FireMask/OpenPlayer/docs/pcb-requirements.md

# OpenPlayer PCB Rev C — Project Requirements

**Document type:** Hardware requirements and design brief  
**Status:** Rev A designed in SPEC 22 (`specs/22-carrier-pcb.md`), reworked into the thin, single-sided Rev B in SPEC 24 (`specs/24-carrier-pcb-rev-b.md`), then into the Rev C Pi sandwich in SPEC 25 (`specs/25-carrier-pcb-rev-c.md`); sources in `hardware/pcb/`  
**Target CAD:** KiCad 10  
**Target manufacturer:** JLCPCB  
**Main controller:** Raspberry Pi Zero 2 W  
**Display:** 1.28-inch round TFT, GC9A01, 240 × 240, SPI  
**Battery concept:** Single-cell LiPo, nominal 3.7 V, 4000 mAh, 6 × 60 × 91.5 mm  
**Charging module:** FM5324GA USB-C charge/boost board (DWEII, Amazon MX B09YD5C9QC), 5 V / 2 A output  
**Revision:** C (Rev A and Rev B only in git history)

---

## 1. Project goal

Design a custom printed circuit board (PCB) for a portable, modular DIY MP3 player named **OpenPlayer**. The current prototype works at a basic level on a Raspberry Pi Zero 2 W. The PCB is a **bridge board**: it contains no active circuitry, only reliable, labeled, serviceable connectors for:

- Raspberry Pi Zero 2 W, plugged into a 2 × 20 socket on the back of the board (HAT style, 11 mm standoffs).
- A 1.28-inch round GC9A01 240 × 240 SPI TFT display ("1.28 TFT ver 1.0", 7-pin header, no backlight pin), soldered on the front of the board by its own header.
- Six physical control buttons on a separate button board.
- A power-on key on the case's top edge.
- The 5 V output and `K` (key) pad of the charging module, connected by short wires.
- A panel-mount power switch, connected by short wires.

The battery connects straight to the charging module and never touches this PCB.

**Case target:** portrait, Walkman size, ≈ 80 W × 110 H × 33 D mm (inside ≈ 74 × 104 × 29), held in the right hand. Front to back: display, carrier, Pi, insulating sheet, battery (~28.3 mm in all). The carrier and Pi take the top ≈ 53 mm; the bottom zone holds the charging module, USB OTG adapter and DAC, with the headphone jack and charging USB-C in the bottom wall. Button strip on the right wall, POWER key on the top edge.

## 2. Existing software and system architecture

The PCB is hardware interconnect and power distribution; it is not intended to replace the Raspberry Pi or run application software itself.

The Raspberry Pi Zero 2 W will continue running Raspberry Pi OS and the existing MP3-player software architecture:

- MPD as the playback engine and source of playback state.
- A central C#/.NET service for player logic.
- A Python GPIO hardware agent for physical button input and display rendering (pins configurable in `player.json`; defaults below).
- SSH for administration.
- SPI display control for the GC9A01.
- Existing USB DAC for audio output.
- Bluetooth headphone output is a desired capability of the software/system, not a PCB audio codec requirement.

Do not move the project to an ESP32 as part of this PCB revision.

## 3. Design principles

1. **Modular:** the Pi, battery, charging module, display, and button board are replaceable without reworking the PCB.
2. **Safe power design:** no direct connection from a Li-ion cell to the Pi's 5 V supply input. Only the module's regulated 5 V reaches the PCB.
3. **Power-path:** handled by the charging module; the PCB adds none.
4. **Stable 5 V rail:** both Pi 5 V pins and all GND pins carry power through J1; optional bulk capacitor C1.
5. **Serviceable:** keyed/polarized connectors, clear silkscreen labels, mounting holes, and test points.
6. **KiCad source-first:** schematic and PCB are generated by scripts in `hardware/pcb/scripts/` and kept under version control.
7. **Fabrication-ready:** Gerbers and drill files for JLCPCB only after ERC/DRC and physical review.
8. **Do not assume module pinouts:** verify each purchased module's exact pin labels, connector pitch, voltage limits, and datasheet before ordering.

## 4. Functional blocks

### 4.1 Raspberry Pi connection — J1

- J1: 2 × 20, 2.54 mm female socket, vertical, 8.5 mm tall, on the **back**. The Pi plugs in component side toward the carrier, like a HAT. J1 pin N = Pi physical pin N.
- The Pi's outline is flush with the carrier's bottom edge, so its ports (mini-HDMI, USB OTG, PWR) face the bottom of the case. Four M2.5 holes on the Pi's 58 × 23 pattern carry 11 mm standoffs (socket 8.5 + Pi header plastic 2.5).
- `build_pcb.py` checks every J1 pad against the official Pi Zero 2 W drawing (pin 1 at the left end, inner row, seen from the front). A mirrored J1 would put 5 V on GPIO.
- No copper pour over the Pi's Wi-Fi/BT antenna (between its mini-HDMI and USB OTG ports).
- The Pi is powered through header pins 2 and 4 (5 V) with all 8 GND pins (6, 9, 14, 20, 25, 30, 34, 39).
- **Never plug power into the Pi's micro-USB PWR port while it is on the carrier** (dual feed). The silkscreen carries this warning; block the port in the enclosure.
- Measure 5 V at the Pi under load at bring-up; it must stay ≥ 4.75 V.

### 4.2 Display connector — J5

Display: GC9A01, 1.28-inch round TFT, 240 × 240, SPI. J5 is a row of 7 plated holes (2.54 mm) for the module's own pre-soldered 1 × 7 header: the module sits on the **front**, its header goes through the board and is soldered on the back (pins trimmed to ≤ 2 mm). No cable. **Pin 1 (VCC, square pad) is the rightmost pin seen from the front.** Swapping the display means desoldering it.

Measured module ("1.28" TFT VER1.0"): 36 W × 45 H × 4 mm (round Ø36 + 23 mm-wide bottom tab); pin row 2 mm above the module's bottom edge (= the carrier's bottom edge) and 25 mm below the screen center; two M2 tab holes 19.2 mm apart, 3.5 mm above the pin row, carried on 2.5 mm standoffs (H5/H6).

7-position interface, in the module's silkscreen order. Matches the validated prototype wiring (`docs/gpio-map.md` §10) and `player.json` defaults (`hardware.display.dc` = 16, `rst` = 26):

| J5 pin | Module label | Signal | Raspberry Pi BCM GPIO | Pi physical pin |
|---:|---|---|---:|---:|
| 1 | VCC | 3V3 | — | 1, 17 |
| 2 | GND | GND | — | any GND |
| 3 | SCL | SPI0 SCLK | GPIO11 | 23 |
| 4 | SDA | SPI0 MOSI | GPIO10 | 19 |
| 5 | DC | Data/command | GPIO16 | 36 |
| 6 | CS | SPI0 CE0 | GPIO8 | 24 |
| 7 | RST | Reset | GPIO26 | 37 |

Important:
- SDA/SCL on this module are SPI data/clock, not I²C.
- VCC and logic are 3.3 V only; never 5 V.
- The module has no backlight (BL) pin: the backlight is on whenever VCC is present, including after the Pi shuts down. The charging module's auto-off (load < 50 mA) or the J6 power switch cuts it. A panel VCC MOSFET switch is left for a future spec.
- DC/RST were moved from GPIO5/GPIO6 (pins 29/31) to GPIO16/GPIO26 (pins 36/37) after a short between adjacent header pins 29–31 on the prototype. Do not revert without updating `player.json` defaults.
- SPI0 is in use, so GPIO7–11 are not free for other functions.

### 4.3 Button board connector — J4

One 8-pin JST-XH connector (right edge) to a separate button board with six normally-open momentary buttons and a shared ground. Pin 8 keeps `PWR_KEY` so the existing XH-8 cable still works; the 6-key button board leaves it unconnected.

| J4 pin | Signal | Raspberry Pi BCM GPIO | Pi physical pin |
|---:|---|---:|---:|
| 1 | GND common | — | GND |
| 2 | PLAY / PAUSE | GPIO17 | 11 |
| 3 | PREVIOUS | GPIO27 | 13 |
| 4 | NEXT | GPIO22 | 15 |
| 5 | VOL_UP | GPIO23 | 16 |
| 6 | VOL_DOWN | GPIO24 | 18 |
| 7 | MENU | GPIO25 | 22 |
| 8 | PWR_KEY | — (to J3, module `K`) | — |

Pin assignment matches `player.json` defaults and `docs/gpio-map.md`.

Button behavior:
- Each normally-open button connects its signal line to GND while pressed.
- GPIO inputs use the internal pull-up in software; no external resistors.
- `PWR_KEY` is **not** a Pi GPIO. It goes only to the charging module's `K` pad (via J3), so power-on works with the Pi off.
- The POWER key is a panel momentary key on the case's top edge, on **J7 `PWR_BTN`** (JST-XH 2 side entry, top edge): pin 1 `PWR_KEY`, pin 2 `GND`.

### 4.4 Battery and charging module

- Battery: one LiPo cell, 3.7 V nominal, 4000 mAh, 6 × 60 × 91.5 mm, with built-in protection, flat against the back wall behind the Pi (1 mm gap / insulating sheet; keep it off the Pi's antenna end if possible). It connects straight to the module's `+` / `−` battery pads. The 5000 mAh 4 × 59 × 134 cell was dropped: it needs a ~145 mm case.
- Charging module: FM5324GA USB-C board. Per seller listings (unverified against a datasheet):
  - USB-C input 5 V, charge current up to 2.4 A, cut-off 4.2 V.
  - Integrated boost: 5 V regulated output, up to 2 A, ~92.5 % efficiency at 3.6 V in.
  - A short press on `K` turns the output on; the output turns off when the load stays below ~50 mA.
  - 4 battery-level LEDs. A USB-A output on the back is not used.
- Pads used: `5V +` / `−` (output) → J2; `K` → J3. Wires are short; the module sits in the bottom zone of the case.
- The Steren ARD-343 (TP4056 type) was rejected: battery-voltage output only, no power-path, 2 A trip limit.

### 4.5 Power entry and switch — J2, J6

- J2 `PWR_IN` (JST-XH 2-pin, left edge): module 5V / GND → `5V_IN`.
- J6 `SWITCH` (JST-XH 2-pin, left edge): panel-mount rocker/toggle rated ≥ 3 A, in series between `5V_IN` and `5V_SYS`.
- `5V_SYS` feeds J1 pins 2 and 4, C1 (470 µF / 10 V, Ø8 mm, mounted lying flat, optional populate) and C2 (100 nF).
- Power tracks (`5V_IN`, `5V_SYS`, `GND`) are ≥ 1.0 mm.

### 4.6 Expansion and future additions

- Keep GPIO2/GPIO3 available for potential I²C devices.
- OLED is not part of this revision; the current screen target is the GC9A01 TFT.
- Do not add an audio DAC to this PCB; the current prototype uses an existing USB DAC.

### 4.7 Button board (SPEC 23, 6 keys since SPEC 25)

A separate 14 mm-wide strip that lies flat against the right side wall of the case (Walkman-style). Files and regeneration: `hardware/buttons/README.md`.

- SW2–SW7: 6 × 6 mm THT tactile switches (`SW_PUSH_6mm`) on the front, in one row. Top to bottom: VOL+ VOL− | PREV PLAY NEXT MENU, with a larger gap between the two groups so they can be found by touch. Actuator height is picked at purchase; all heights share the footprint. SW1 (POWER) was removed: the POWER key is on the carrier's J7.
- J1 `CARRIER`: JST-XH 8 on the back at the top end, lying along the strip. Same pinout as carrier J4 (1 GND, 2 PLAY, 3 PREV, 4 NEXT, 5 VOL+, 6 VOL−, 7 MENU, 8 KEY); pin 8 is unconnected on this board. `hardware/buttons/scripts/netlist.py` checks this against the carrier's netlist.
- **Cable:** XH-8 to XH-8, **straight**: pin 1 to pin 1 … pin 8 to pin 8. Pin 1 is marked on both boards; check continuity before connecting.
- H1–H2: M2 holes, one at each end.
- Each switch shorts its signal to GND; no pull-ups, debounce parts, LEDs or ESD parts on the board (pull-ups and debounce are in the Pi/software).
- Size: `BOARD_W` 14 mm; length follows from `BTN_PITCH` (9.6 mm), `GROUP_GAP` (4 mm) and `END_MARGIN` (5.5 mm): 100.09 mm by default (fits the ≈ 104 mm inside height).
- Two layers: signals on F.Cu, GND pour on B.Cu with F.Cu stitching.

## 5. Connector list

| Ref. | Function | Pins | Footprint |
|---|---|---:|---|
| J1 | Pi, plugged in on the back | 40 | `Connector_PinSocket_2.54mm:PinSocket_2x20_P2.54mm_Vertical` (8.5 mm) |
| J2 | `PWR_IN` from module 5 V | 2 | JST-XH S2B-XH-A (side entry) |
| J3 | `KEY` to module `K` | 2 | JST-XH S2B-XH-A (side entry) |
| J4 | `BUTTONS` | 8 | JST-XH S8B-XH-A (side entry) |
| J5 | `DISPLAY`, holes for the module's own header (nothing to buy) | 7 | `Connector_PinHeader_2.54mm:PinHeader_1x07_P2.54mm_Vertical` |
| J6 | `SWITCH` to panel switch | 2 | JST-XH S2B-XH-A (side entry) |
| J7 | `PWR_BTN` to the panel POWER key | 2 | JST-XH S2B-XH-A (side entry) |
| C1 | Bulk 5V_SYS (optional), lying flat | 2 | `CP_Radial_D8.0mm_P3.50mm` |
| C2 | 100 nF 5V_SYS | 2 | `C_Disc_D5.0mm_W2.5mm_P5.00mm` |
| TP1 | GND | 1 | THT test pad |
| TP2 | 5V_SYS | 1 | THT test pad |
| TP3 | 3V3 | 1 | THT test pad |
| H1–H4 | M2.5 holes on the Pi's pattern, 11 mm standoffs | — | `MountingHole_2.7mm_M2.5` |
| H5–H6 | M2 holes under the display tab, 2.5 mm standoffs | — | `MountingHole_2.2mm_M2` |

## 6. GPIO conflict review

| Function | BCM GPIO | Physical pin |
|---|---:|---:|
| Display MOSI | 10 | 19 |
| Display SCLK | 11 | 23 |
| Display CS / CE0 | 8 | 24 |
| Display DC | 16 | 36 |
| Display RST | 26 | 37 |
| PLAY / PAUSE | 17 | 11 |
| PREVIOUS | 27 | 13 |
| NEXT | 22 | 15 |
| VOL_UP | 23 | 16 |
| VOL_DOWN | 24 | 18 |
| MENU | 25 | 22 |

Electrical constraints:
- Raspberry Pi GPIO is 3.3 V logic and is not 5 V tolerant.
- All modules share the PCB ground.
- Keep GPIO17/22/23/24/25/27 (buttons), GPIO7–11 (SPI0) and GPIO16/26 (display) reserved. The hardware agent rejects duplicate pins in `player.json`.
- `hardware/pcb/scripts/netlist.py` asserts that the PCB nets match `config/player.example.json`.

## 7. PCB layout

- Two layers, GND pour on both sides, JLCPCB default rules.
- **Stack** (front to back, ~28.3 mm in a ≈ 33 mm case): display module + header spacer 6.5, carrier 1.6, gap 11 (J1 socket 8.5 + Pi header 2.5), Pi ~2.2, gap / insulating sheet 1, battery 6. The user prefers a thicker player over a larger one; this reverses SPEC 24's "no sandwich" decision (17 mm target).
- **Height rule** for the back parts: part height + Pi part under it ≤ 10.5 mm (0.5 mm air in the 11 mm gap). Table per part in `hardware/pcb/README.md`. C1/C2 stay off the Pi's port edge.
- **Two-sided:** the display on the front; J1, every cable connector, C1, C2 and the test points on the back, in the gap between the boards.
- Board 65 × 53 mm (`BOARD_W` / `BOARD_H` in `build_pcb.py`). The width is the Pi's. The Pi (30 mm) sits flush with the bottom edge; the 23 mm band above it holds J4 (23.5 mm long), which does not fit on the right edge between the Pi's holes (17 mm). SPEC 25 first estimated ≈ 45 mm.
- **Edges** (seen from the front), every mouth at the edge so the wires run parallel to the board:
  - Top: J7 `PWR_BTN`, to the POWER key on the case's top edge.
  - Left edge: J2 `PWR_IN`, J6 `SWITCH` (top band), J3 `KEY` (between the Pi's holes).
  - Right edge, top band: J4 `BUTTONS`, toward the button strip.
  - Bottom: the Pi's ports.
- Holes: four M2.5 on the Pi's pattern (H1–H4), two M2 under the display's tab (H5/H6).
- **Antenna keep-out:** no copper pour on either layer over the Pi's antenna (x 18–37 mm, bottom 7 mm). The display's pads and tracks cross it.
- Keep SPI away from the 5 V entry.
- Silkscreen: board name, "Rev C", connector names, pin 1 (J1 on both sides), the display outline on the front, J4 signal names (front, right of the display), J5 signal names (back, by the solder joints), the Pi's top edge, C1 body outline, and the micro-USB warning. Nothing under the display body on the front.

## 8. KiCad project and fabrication workflow

See `hardware/pcb/README.md` (button board: `hardware/buttons/README.md`, same flow with `-Board buttons`). Both boards share `hardware/common/pcbgen.py`. In short: `netlist.py` (single source of truth) → `build_sch.py` → `build_pcb.py` → `hardware/common/export-fab.ps1 -Board pcb`, with ERC and DRC (schematic parity) through `kicad-cli`. Do not treat a clean ERC/DRC report as proof that the power circuit is safe.

## 9. Validation and bring-up checklist

### Before fabrication
- [ ] Display module pinout verified against the physical module: VCC is the rightmost J5 pin seen from the front.
- [ ] J1 overlaid on the Pi: pin 1 matches with the Pi component side toward the carrier (continuity check before first power).
- [ ] Button board pin order matches J4.
- [ ] Battery chemistry, voltage limits, current capability and protection verified.
- [ ] Charging module pads (`5V +`, `−`, `K`, battery) identified on the real board.
- [ ] ERC clean or every remaining warning understood.
- [ ] DRC clean or every remaining warning understood.
- [ ] 3D renders and connector orientation reviewed.
- [ ] Gerbers and drill files inspected in JLCPCB's viewer.

### First power-up
- [ ] Do not connect the Raspberry Pi initially.
- [ ] Inspect PCB for shorts, solder bridges, reversed connectors and incorrect polarity.
- [ ] Verify battery polarity at the module with a meter.
- [ ] Verify 5 V at TP2 with the switch on, and 0 V with it off.
- [ ] Check heating and voltage droop under a test load.
- [ ] Only then connect the Pi and check for stable boot; measure 5 V at the Pi under load (≥ 4.75 V).
- [ ] Plug and unplug USB-C while playing; if the Pi resets, populate C1 and retest.
- [ ] Measure halted current after `power_off`; confirm whether the module auto-shuts off.
- [ ] Test screen, each button, `PWR_KEY`, USB DAC, Wi-Fi and Bluetooth.

## 10. Open questions

1. Exact battery model, connector, maximum discharge current, and protection.
2. FM5324GA datasheet: confirm charge-while-discharge without output dropout.
3. Whether the module auto-shuts off with the Pi halted (> 50 mA would keep it on).
4. Enclosure design and the DAC choice / mounting in the bottom zone.
5. Whether to add a panel VCC switch for the display (module has no BL pin).
6. Real heights of the Pi's top-side parts (typical values used for the height rule) and of the chosen standoffs.
7. Exact antenna area on the Pi Zero 2 W (keep-out assumed between its mini-HDMI and USB OTG ports), Wi-Fi/BT range with the carrier, display and battery around it, and SoC / battery temperature under load (battery < 45 °C).

## 11. Explicit non-goals for Rev A – Rev C

- Replacing the Raspberry Pi with an ESP32.
- Designing a custom audio DAC; the current USB DAC remains external.
- Adding the OLED display; the GC9A01 TFT is the target for this revision.
- Designing a charger or boost circuit on the PCB.
- Battery voltage sense / low-battery signal to the Pi.
- Fabricating a production batch before electrical, mechanical, and thermal validation.

**Safety note:** This is a requirements brief, not a verified circuit design. The charging module's behavior must be validated against its datasheet and tested before connecting the Raspberry Pi or enclosing the battery.
