FireMask/OpenPlayer/docs/screen-sides.jpg

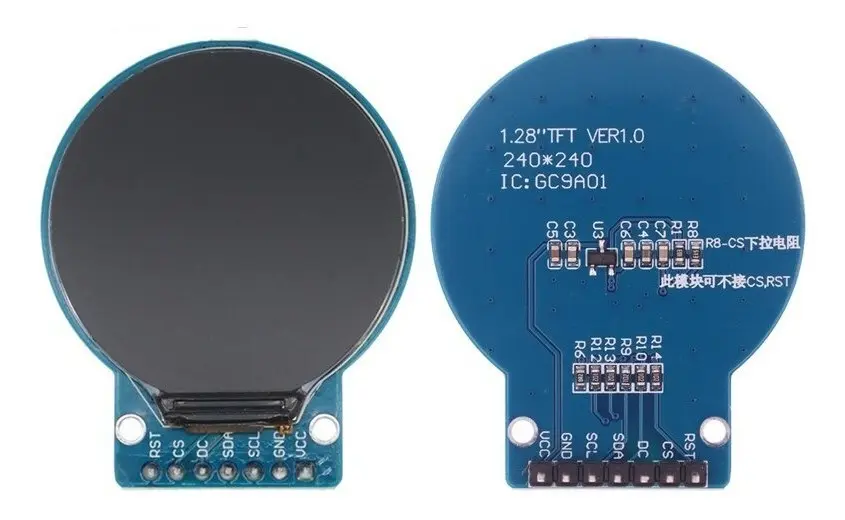
docs/screen-sides.jpg
