FireMask/OpenPlayer/docs/screen.jpg

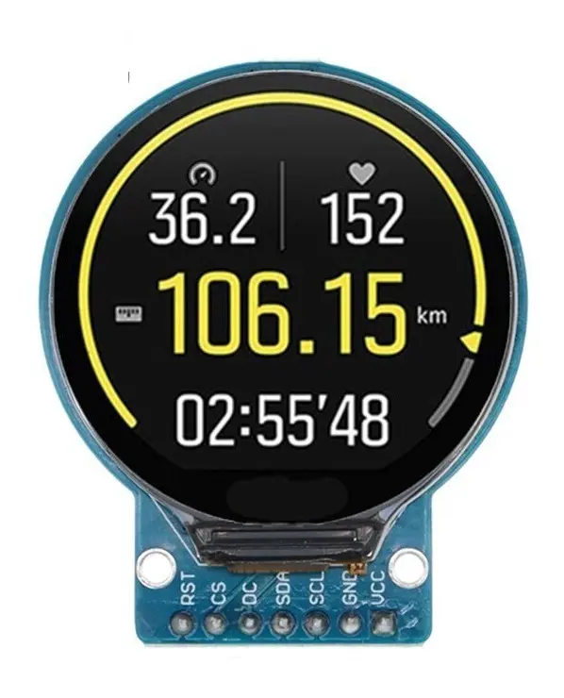
docs/screen.jpg
