FireMask/OpenPlayer/hardware/pcb/fabrication/openplayer-carrier-bom.csv

Refs | Value | Footprint | Description | Qty
C1 | 470uF 10V | Capacitor_THT:CP_Radial_D8.0mm_P3.50mm |  | 1
C2 | 100nF | Capacitor_THT:C_Disc_D5.0mm_W2.5mm_P5.00mm |  | 1
J1 | Pi_40pin_socket | Connector_PinSocket_2.54mm:PinSocket_2x20_P2.54mm_Vertical |  | 1
J2 | PWR_IN | Connector_JST:JST_XH_S2B-XH-A_1x02_P2.50mm_Horizontal |  | 1
J3 | KEY | Connector_JST:JST_XH_S2B-XH-A_1x02_P2.50mm_Horizontal |  | 1
J4 | BUTTONS | Connector_JST:JST_XH_S8B-XH-A_1x08_P2.50mm_Horizontal |  | 1
J6 | SWITCH | Connector_JST:JST_XH_S2B-XH-A_1x02_P2.50mm_Horizontal |  | 1
J7 | PWR_BTN | Connector_JST:JST_XH_S2B-XH-A_1x02_P2.50mm_Horizontal |  | 1
