FireMask/OpenPlayer/docs/measures-player.png

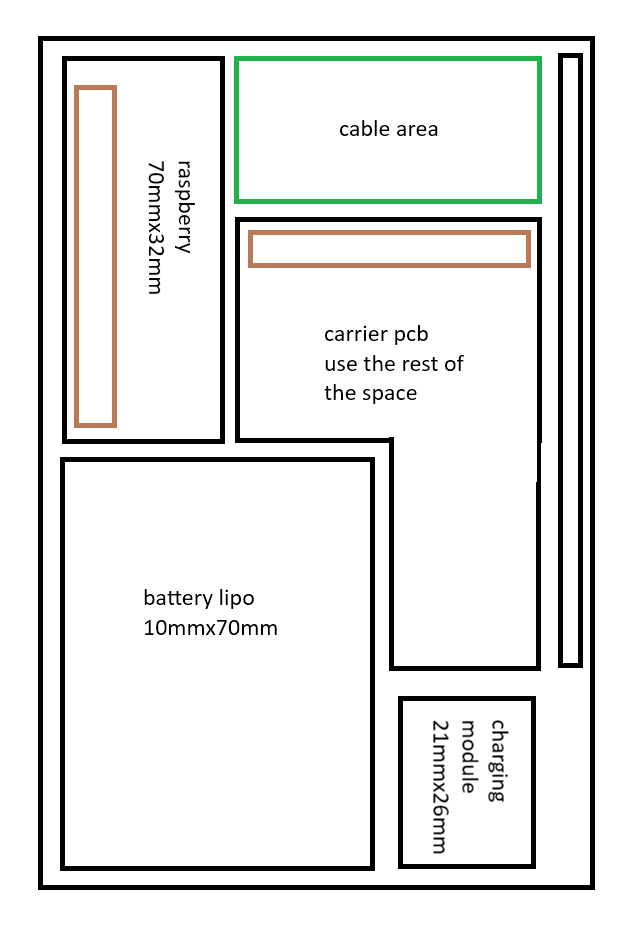
docs/measures-player.png
