FireMask/OpenPlayer/hardware/pcb/openplayer-carrier.kicad_pcb

## KiCad design hardware/pcb/openplayer-carrier.kicad_pcb (2026-10-27)

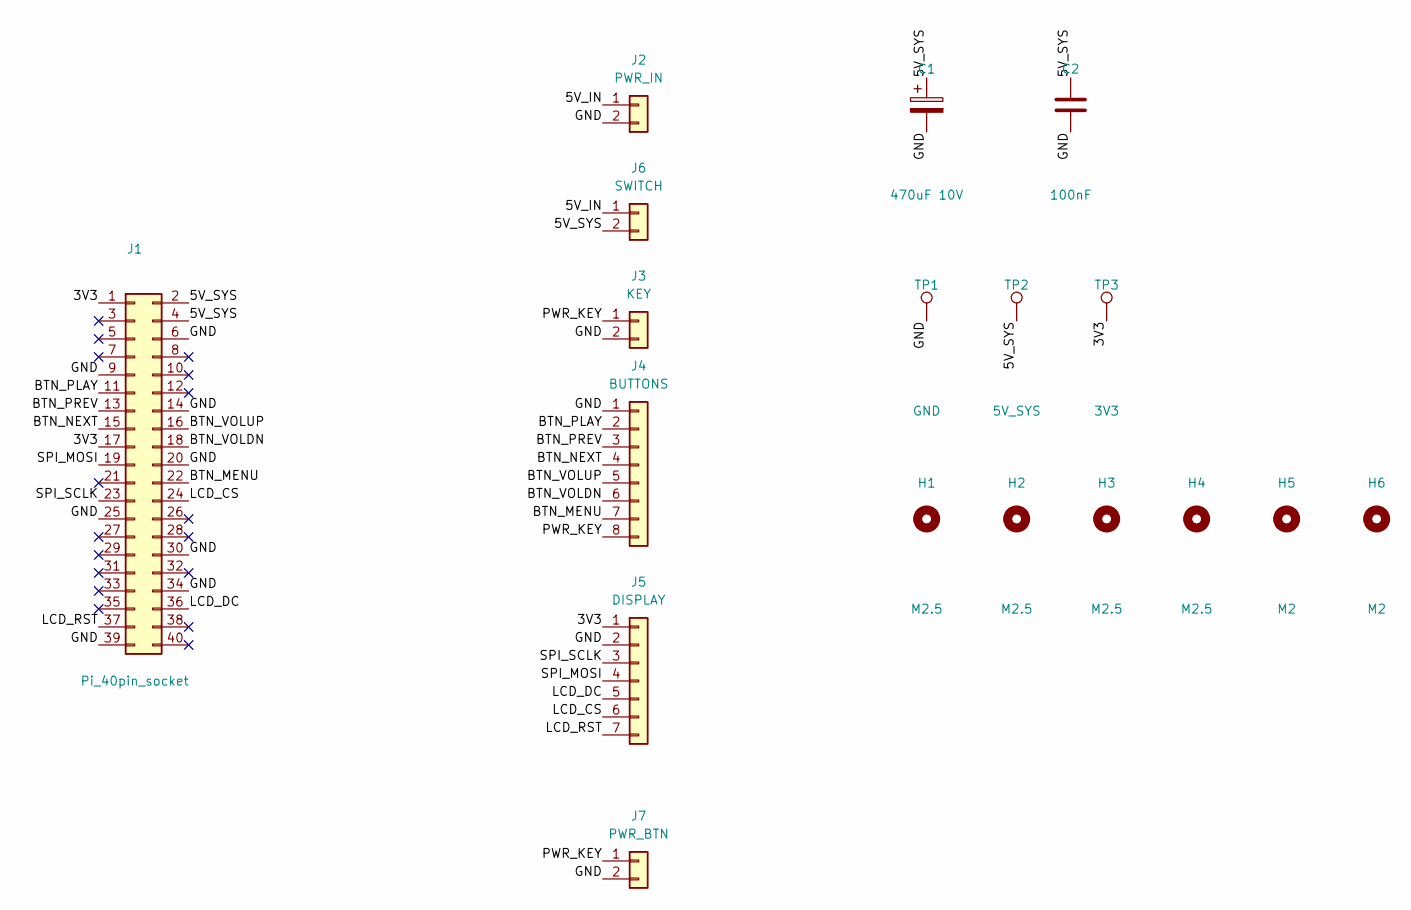
[picture p8: schematic openplayer-carrier.kicad_sch, OpenPlayer carrier]

Parts:
C1: 470uF 10V; CP_Radial_D8.0mm_P3.50mm
C2: 100nF; C_Disc_D5.0mm_W2.5mm_P5.00mm
H1, H2, H3, H4: M2.5; MountingHole_2.7mm_M2.5
H5, H6: M2; MountingHole_2.2mm_M2
J1: Pi_40pin_socket; PinSocket_2x20_P2.54mm_Vertical
J2: PWR_IN; JST_XH_S2B-XH-A_1x02_P2.50mm_Horizontal
J3: KEY; JST_XH_S2B-XH-A_1x02_P2.50mm_Horizontal
J4: BUTTONS; JST_XH_S8B-XH-A_1x08_P2.50mm_Horizontal
J5: DISPLAY; PinHeader_1x07_P2.54mm_Vertical
J6: SWITCH; JST_XH_S2B-XH-A_1x02_P2.50mm_Horizontal
J7: PWR_BTN; JST_XH_S2B-XH-A_1x02_P2.50mm_Horizontal
TP1: GND; TestPoint_THTPad_D2.0mm_Drill1.0mm
TP2: 5V_SYS; TestPoint_THTPad_D2.0mm_Drill1.0mm
TP3: 3V3; TestPoint_THTPad_D2.0mm_Drill1.0mm

Connections:
/3V3: J1.1, J1.17, J5.1, TP3.1
/5V_IN: J2.1, J6.1
/5V_SYS: C1.1, C2.1, J1.2, J1.4, J6.2, TP2.1
/BTN_MENU: J1.22, J4.7
/BTN_NEXT: J1.15, J4.4
/BTN_PLAY: J1.11, J4.2
/BTN_PREV: J1.13, J4.3
/BTN_VOLDN: J1.18, J4.6
/BTN_VOLUP: J1.16, J4.5
/GND: C1.2, C2.2, J1.6, J1.9, J1.14, J1.20, J1.25, J1.30, J1.34, J1.39, J2.2, J3.2, J4.1, J5.2, J7.2, TP1.1
/LCD_CS: J1.24, J5.6
/LCD_DC: J1.36, J5.5
/LCD_RST: J1.37, J5.7
/PWR_KEY: J3.1, J4.8, J7.1
/SPI_MOSI: J1.19, J5.4
/SPI_SCLK: J1.23, J5.3

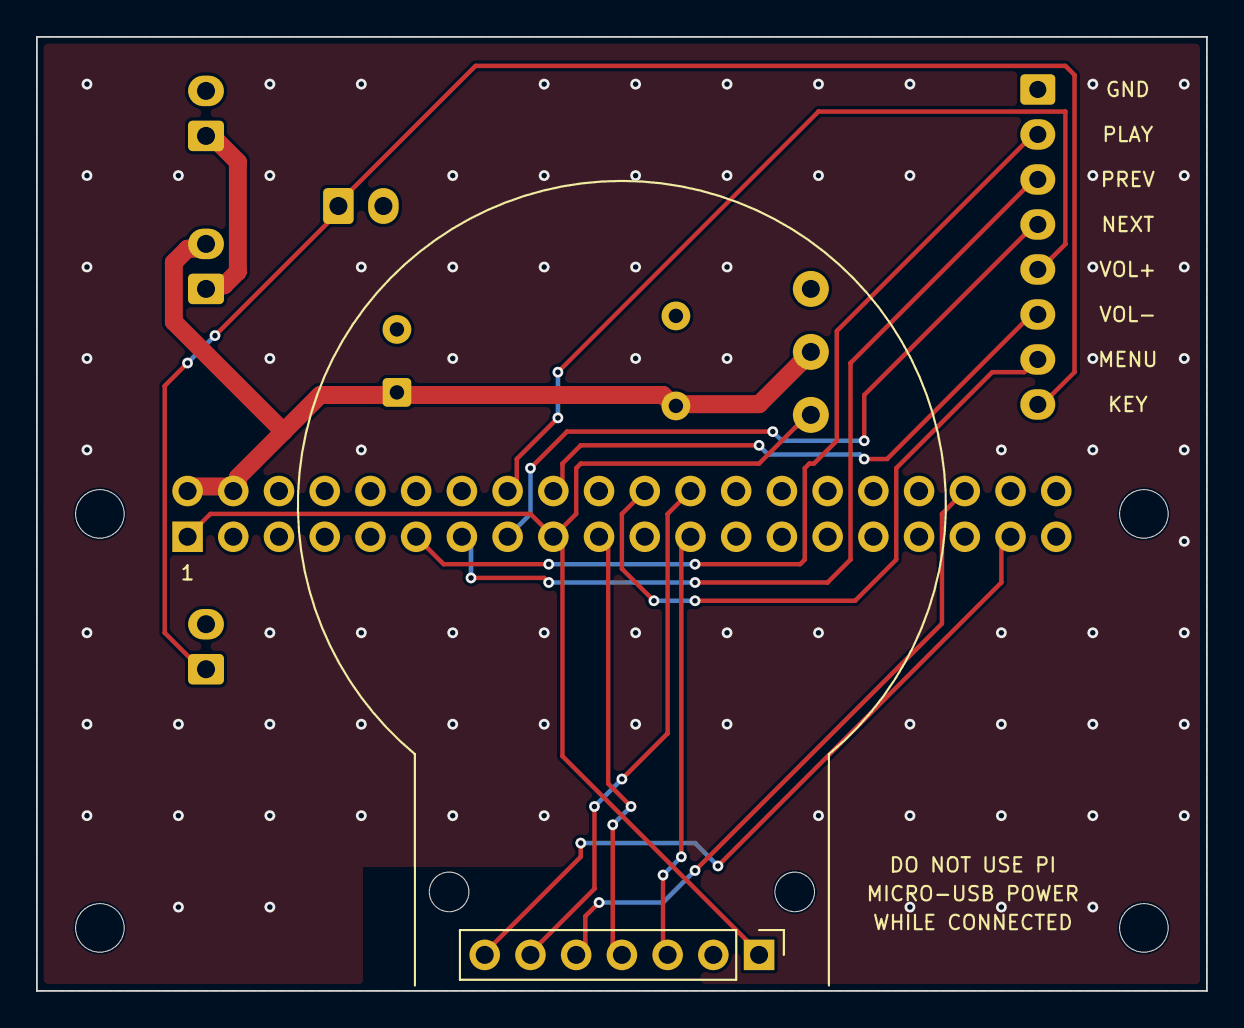
[picture p9: board openplayer-carrier.kicad_pcb from above]

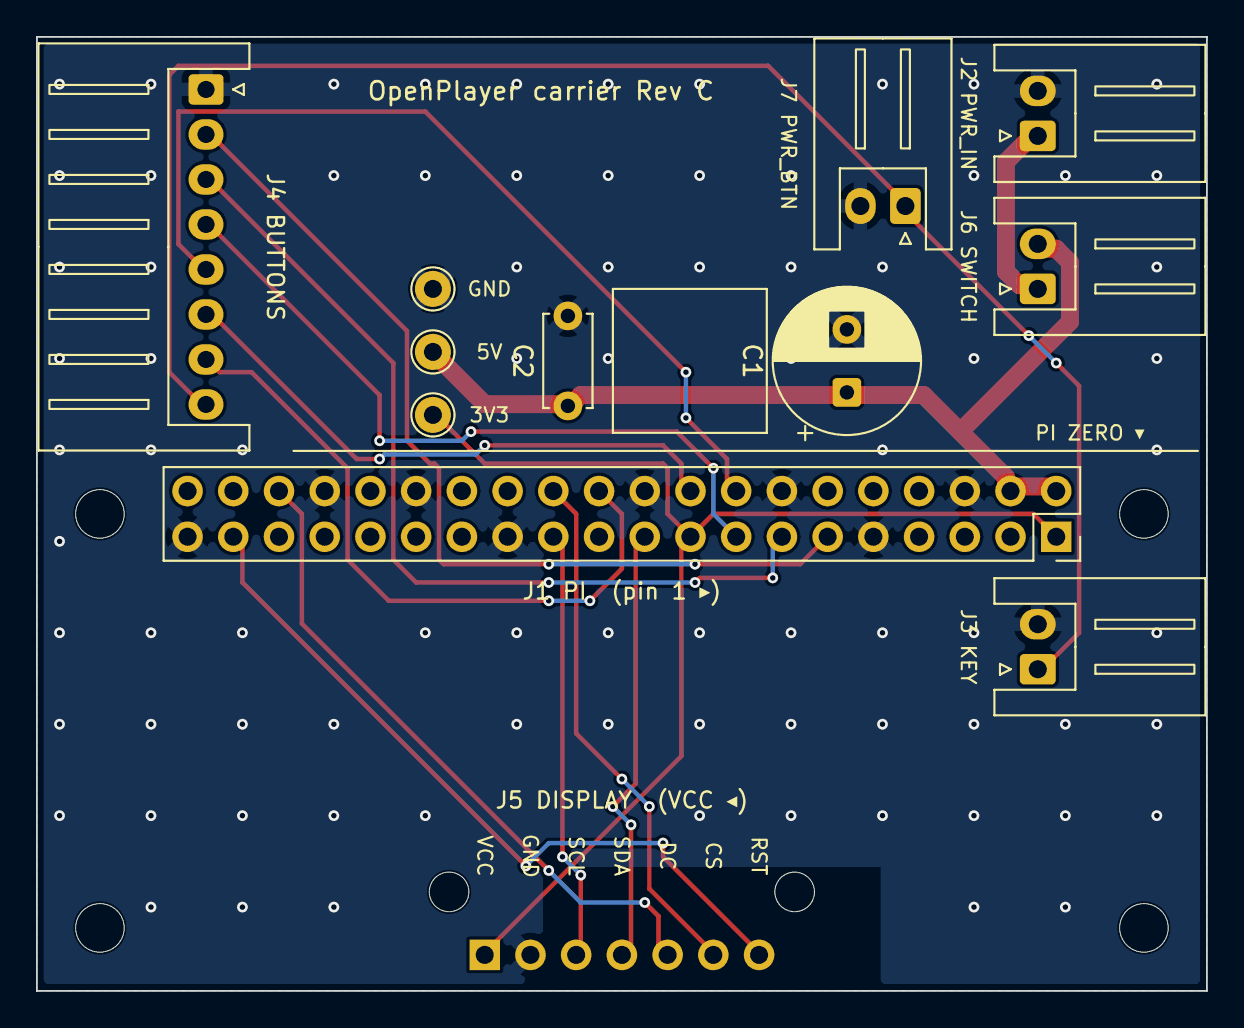
[picture p10: board openplayer-carrier.kicad_pcb from below]

Board: 2 copper layers, 65.0 x 53.0 mm, 18 parts (11 on the bottom side), 16 nets.
