FireMask/OpenPlayer/hardware/buttons/openplayer-buttons.kicad_pcb

## KiCad design hardware/buttons/openplayer-buttons.kicad_pcb (2026-10-27)

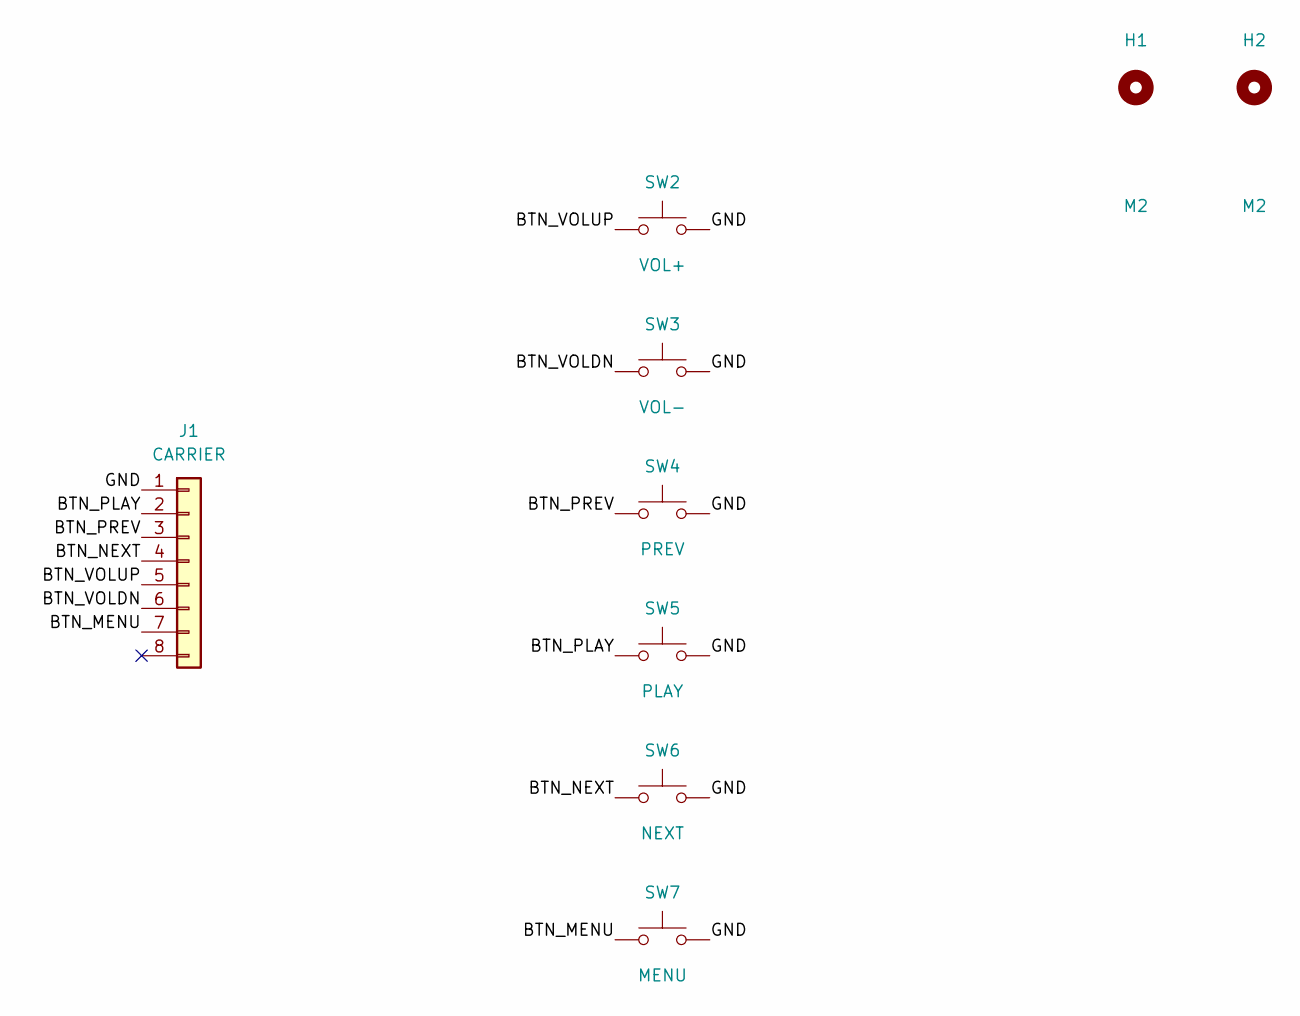
[picture p11: schematic openplayer-buttons.kicad_sch, OpenPlayer buttons]

Parts:
H1, H2: M2; MountingHole_2.2mm_M2
J1: CARRIER; JST_XH_B8B-XH-A_1x08_P2.50mm_Vertical
SW2: VOL+; SW_PUSH_6mm
SW3: VOL-; SW_PUSH_6mm
SW4: PREV; SW_PUSH_6mm
SW5: PLAY; SW_PUSH_6mm
SW6: NEXT; SW_PUSH_6mm
SW7: MENU; SW_PUSH_6mm

Connections:
/BTN_MENU: J1.7, SW7.1
/BTN_NEXT: J1.4, SW6.1
/BTN_PLAY: J1.2, SW5.1
/BTN_PREV: J1.3, SW4.1
/BTN_VOLDN: J1.6, SW3.1
/BTN_VOLUP: J1.5, SW2.1
/GND: J1.1, SW2.2, SW3.2, SW4.2, SW5.2, SW6.2, SW7.2

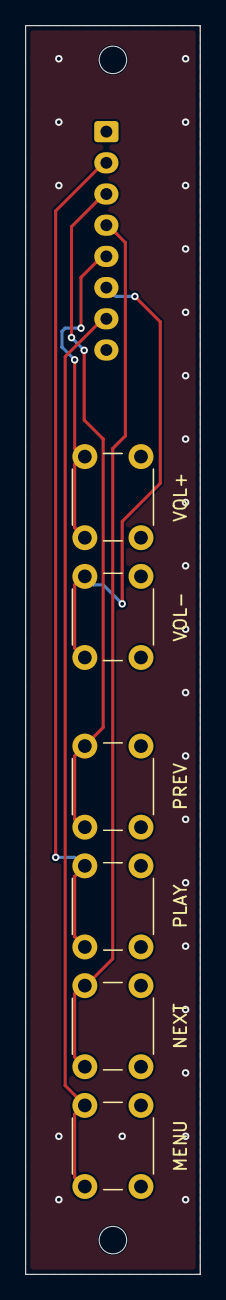
[picture p12: board openplayer-buttons.kicad_pcb from above]

Board: 2 copper layers, 14.0 x 100.1 mm, 9 parts (1 on the bottom side), 7 nets.
