FireMask/OpenPlayer/tests/hardware-agent/test_display.py

import base64
import io
import json
import logging
import socket
import threading
import time
from dataclasses import replace
from datetime import datetime, time as clock_time, timedelta

import pytest
from PIL import Image

from display import SCROLL_PAUSE, SCROLL_SPEED, WAKE_SECONDS, Display, in_range, parse, scroll_offset
from screen import MenuView, View, render, title_overflow


def wait_until(condition, timeout=5.0):
    deadline = time.monotonic() + timeout
    while time.monotonic() < deadline:
        if condition():
            return
        time.sleep(0.01)
    raise AssertionError("condition not met within timeout")


def snapshot(state="playing", title="Song", artist="Artist", position=10, duration=100, volume=35, mode="track",
             album=None):
    return {"type": "player.snapshot", "state": state, "trackTitle": title, "trackArtist": artist,
            "trackAlbum": album, "positionSeconds": position, "durationSeconds": duration, "volume": volume,
            "queuePosition": 0, "queueVersion": 1, "displayMode": mode}


class FakeClock:
    """monotonic() y now() controlados por la prueba: el tiempo solo avanza con advance()."""

    START = datetime(2026, 10, 24, 21, 47, 30)  # sábado

    def __init__(self):
        self.t = 1000.0

    def advance(self, seconds):
        self.t += seconds

    def monotonic(self):
        return self.t

    def now(self):
        return self.START + timedelta(seconds=self.t - 1000.0)


class FakeService:
    """Service falso por TCP: acepta suscripciones y empuja líneas a la conexión activa.
    player.get_cover (SPEC 19) responde la carátula de covers[álbum del último snapshot empujado]."""

    def __init__(self):
        self.available = True
        self.subscriptions = []  # primera línea de cada conexión de suscripción
        self.covers = {}  # álbum → bytes de la imagen; ausente = sin carátula
        self.cover_requests = []  # álbum vigente en cada player.get_cover
        self.cover_gate = threading.Event()  # se responde cuando está puesto
        self.cover_gate.set()
        self._album = None
        self._conns = []
        self._listener = socket.create_server(("127.0.0.1", 0))
        self._port = self._listener.getsockname()[1]
        threading.Thread(target=self._accept, daemon=True).start()

    def connect(self):
        if not self.available:
            raise ConnectionRefusedError("fake service unavailable")
        return socket.create_connection(("127.0.0.1", self._port), timeout=1)

    def push(self, message):
        self._album = message.get("trackAlbum", self._album)
        self._conns[-1].sendall((json.dumps(message) + "\n").encode("utf-8"))

    def drop(self):
        for conn in self._conns:
            try:
                conn.shutdown(socket.SHUT_RDWR)
            except OSError:
                pass
            conn.close()

    def close(self):
        self.drop()
        self._listener.close()

    def _accept(self):
        while True:
            try:
                conn, _ = self._listener.accept()
            except OSError:
                return
            line = json.loads(conn.makefile("rb").readline())
            if line.get("type") == "player.get_cover":
                threading.Thread(target=self._reply_cover, args=(conn,), daemon=True).start()
                continue
            self.subscriptions.append(line)
            self._conns.append(conn)

    def _reply_cover(self, conn):
        album = self._album
        self.cover_requests.append(album)
        self.cover_gate.wait(5)
        data = self.covers.get(album)
        reply = {"type": "player.cover", "songId": 1, "mime": "image/png",
                 "data": base64.b64encode(data).decode() if data is not None else None}
        with conn:
            conn.sendall((json.dumps(reply) + "\n").encode())


class FakePanel:
    def __init__(self, fail=False):
        self.fail = fail
        self.images = []
        self.power = []  # "off" / "on" en orden

    def init(self):
        if self.fail:
            raise OSError("no SPI")

    def show(self, image):
        self.images.append(image.tobytes())

    def sleep_display(self):
        self.power.append("off")

    def wake_display(self):
        self.power.append("on")

    def shows(self, view):
        return render(view).tobytes() in self.images


@pytest.fixture
def service():
    s = FakeService()
    yield s
    s.close()


@pytest.fixture
def clock():
    return FakeClock()


@pytest.fixture
def display(service, clock):
    created = []

    def make(panel=None, tick_seconds=0.05, retry_seconds=0.1, idle_clock_seconds=60, real_clock=False, **power):
        panel = panel or FakePanel()
        times = {} if real_clock else {"now": clock.now, "monotonic": clock.monotonic}
        d = Display("/x.sock", panel, connect=service.connect, tick_seconds=tick_seconds, retry_seconds=retry_seconds,
                    idle_clock_seconds=idle_clock_seconds, **power, **times)
        d.start()
        created.append(d)
        return d, panel

    yield make
    for d in created:
        d.stop()


PLAYING = View("playing", "Song", "Artist", position=10, duration=100, volume=35, queue_position=0)


def test_subscribes_and_shows_initial_snapshot(service, display):
    _, panel = display()
    wait_until(lambda: service.subscriptions)
    service.push(snapshot())

    assert service.subscriptions[0] == {"type": "player.subscribe"}
    wait_until(lambda: panel.shows(PLAYING))


def test_new_push_redraws(service, display):
    _, panel = display()
    wait_until(lambda: service.subscriptions)
    service.push(snapshot(state="paused"))
    service.push(snapshot(state="paused", title="Other"))

    wait_until(lambda: panel.shows(View("paused", "Other", "Artist", position=10, duration=100, volume=35, queue_position=0)))


def test_same_view_does_not_redraw(service, display):
    _, panel = display()
    wait_until(lambda: service.subscriptions)
    service.push(snapshot(state="paused"))
    wait_until(lambda: panel.shows(View("paused", "Song", "Artist", position=10, duration=100, volume=35, queue_position=0)))
    count = len(panel.images)

    service.push(snapshot(state="paused"))
    time.sleep(0.3)  # varios ticks
    assert len(panel.images) == count


def test_service_down_shows_offline_and_resubscribes(service, display):
    _, panel = display()
    wait_until(lambda: service.subscriptions)
    service.push(snapshot())
    wait_until(lambda: panel.shows(PLAYING))

    service.available = False
    service.drop()
    count = len(panel.images)
    wait_until(lambda: len(panel.images) > count and panel.images[-1] == render(View("offline")).tobytes())

    service.available = True
    wait_until(lambda: len(service.subscriptions) == 2, timeout=2.5)
    service.push(snapshot(title="Back"))
    wait_until(lambda: panel.shows(View("playing", "Back", "Artist", position=10, duration=100, volume=35, queue_position=0)))


def test_starts_offline_without_service(service, display):
    service.available = False
    _, panel = display()

    wait_until(lambda: panel.shows(View("offline")))


def test_error_line_shows_mpd_error(service, display):
    _, panel = display()
    wait_until(lambda: service.subscriptions)
    service.push({"type": "error", "request": "player.get_snapshot", "message": "MPD unavailable"})

    wait_until(lambda: panel.shows(View("mpd_error")))


def test_position_advances_while_playing(service, display, clock):
    _, panel = display()
    wait_until(lambda: service.subscriptions)
    service.push(snapshot(position=10))
    wait_until(lambda: panel.shows(PLAYING))

    clock.advance(2)
    wait_until(lambda: panel.shows(replace(PLAYING, position=12)))


def test_position_stops_at_duration(service, display, clock):
    _, panel = display()
    wait_until(lambda: service.subscriptions)
    service.push(snapshot(position=98, duration=100))
    wait_until(lambda: panel.shows(View("playing", "Song", "Artist", position=98, duration=100, volume=35, queue_position=0)))
    clock.advance(10)
    wait_until(lambda: panel.shows(View("playing", "Song", "Artist", position=100, duration=100, volume=35, queue_position=0)))
    count = len(panel.images)
    time.sleep(0.2)  # varios ticks: la vista queda en 100 y no se redibuja

    assert len(panel.images) == count


@pytest.mark.parametrize("state", ["paused", "stopped"])
def test_position_does_not_advance_when_not_playing(service, display, clock, state):
    _, panel = display()
    wait_until(lambda: service.subscriptions)
    service.push(snapshot(state=state, position=10))
    wait_until(lambda: panel.shows(View(state, "Song", "Artist", position=10, duration=100, volume=35, queue_position=0)))
    clock.advance(5)
    time.sleep(0.2)

    assert not panel.shows(View(state, "Song", "Artist", position=11, duration=100, volume=35, queue_position=0))


def test_init_failure_logs_error_and_ends_thread(display, caplog):
    with caplog.at_level(logging.ERROR):
        d, panel = display(FakePanel(fail=True))
        wait_until(lambda: not d._thread.is_alive())

    assert "display init failed: no SPI" in caplog.text
    assert panel.images == []


def test_stop_ends_thread(service, display):
    d, _ = display()
    wait_until(lambda: service.subscriptions)
    d.stop()

    assert not d._thread.is_alive()


@pytest.mark.parametrize("line, view", [
    (b'{"type":"player.snapshot","state":"stopped","trackTitle":null}', View("stopped")),
    (b'{"type":"player.snapshot","state":"weird"}', View("stopped")),
    (b'{"type":"error","message":"x"}', View("mpd_error")),
    (b'{"type":"ok"}', None),
    (b'[1]', None),
    (b'not json', None),
])
def test_parse(line, view):
    assert parse(line) == view


# Modos, reloj automático e indicador de volumen (SPEC 18)

CLOCK = {"mode": "clock", "clock": "21:47", "date": "sáb 24 oct"}


def last_view_is(panel, view):
    return panel.images and panel.images[-1] == render(view).tobytes()


def test_parse_reads_new_fields():
    line = json.dumps({**snapshot(), "trackAlbum": "Album", "queuePosition": 2, "queueLength": 12,
                       "displayMode": "clock"}).encode()

    assert parse(line) == View("playing", "Song", "Artist", album="Album", position=10, duration=100, volume=35,
                               queue_position=2, queue_length=12, mode="clock")


@pytest.mark.parametrize("mode", [None, "weird", 3])
def test_parse_unknown_mode_is_track(mode):
    assert parse(json.dumps({**snapshot(), "displayMode": mode}).encode()).mode == "track"


def test_service_clock_mode_shows_local_time_and_spanish_date(service, display):
    _, panel = display()
    wait_until(lambda: service.subscriptions)
    service.push(snapshot(mode="clock"))

    wait_until(lambda: last_view_is(panel, replace(PLAYING, **CLOCK)))


def test_clock_redraws_when_minute_changes_not_every_tick(service, display, clock):
    _, panel = display()
    wait_until(lambda: service.subscriptions)
    service.push(snapshot(state="paused", mode="clock"))
    paused = View("paused", "Song", "Artist", position=10, duration=100, volume=35, queue_position=0, **CLOCK)
    wait_until(lambda: last_view_is(panel, paused))
    count = len(panel.images)

    clock.advance(20)  # 21:47:50
    time.sleep(0.2)
    assert len(panel.images) == count

    clock.advance(15)  # 21:48:05
    wait_until(lambda: last_view_is(panel, replace(paused, clock="21:48")))
    assert len(panel.images) == count + 1


@pytest.mark.parametrize("days, date", [(1, "dom 25 oct"), (2, "lun 26 oct"), (8, "dom 1 nov")])
def test_date_uses_spanish_names(service, display, clock, days, date):
    clock.advance(days * 86400)
    _, panel = display()
    wait_until(lambda: service.subscriptions)
    service.push(snapshot(state="paused", mode="clock"))

    wait_until(lambda: last_view_is(panel, View("paused", "Song", "Artist", position=10, duration=100, volume=35,
                                                queue_position=0, mode="clock", clock="21:47", date=date)))


@pytest.mark.parametrize("state", ["paused", "stopped"])
def test_idle_shows_clock_after_idle_seconds_and_playing_returns_to_track(service, display, clock, state):
    _, panel = display(idle_clock_seconds=60)
    wait_until(lambda: service.subscriptions)
    service.push(snapshot(state=state))
    idle = View(state, "Song", "Artist", position=10, duration=100, volume=35, queue_position=0)
    wait_until(lambda: last_view_is(panel, idle))

    clock.advance(59)
    time.sleep(0.2)
    assert last_view_is(panel, idle)

    clock.advance(1)  # 21:48:30
    wait_until(lambda: last_view_is(panel, replace(idle, mode="clock", clock="21:48", date="sáb 24 oct")))

    service.push(snapshot())
    wait_until(lambda: last_view_is(panel, PLAYING))


def test_repeated_paused_snapshots_do_not_restart_idle_timer(service, display, clock):
    _, panel = display(idle_clock_seconds=60)
    wait_until(lambda: service.subscriptions)
    service.push(snapshot(state="paused"))
    wait_until(lambda: panel.images and len(panel.images) >= 2)
    clock.advance(40)
    service.push(snapshot(state="paused", title="Other"))
    clock.advance(20)

    wait_until(lambda: last_view_is(panel, View("paused", "Other", "Artist", position=10, duration=100, volume=35,
                                                queue_position=0, mode="clock", clock="21:48", date="sáb 24 oct")))


def test_idle_clock_disabled(service, display, clock):
    _, panel = display(idle_clock_seconds=None)
    wait_until(lambda: service.subscriptions)
    service.push(snapshot(state="stopped"))
    stopped = View("stopped", "Song", "Artist", position=10, duration=100, volume=35, queue_position=0)
    wait_until(lambda: last_view_is(panel, stopped))

    clock.advance(3600)
    time.sleep(0.2)
    assert last_view_is(panel, stopped)


def test_volume_change_shows_popup_for_two_seconds(service, display, clock):
    _, panel = display()
    wait_until(lambda: service.subscriptions)
    service.push(snapshot(state="paused"))
    paused = View("paused", "Song", "Artist", position=10, duration=100, volume=35, queue_position=0)
    wait_until(lambda: last_view_is(panel, paused))  # el primer snapshot no muestra el indicador

    service.push(snapshot(state="paused", volume=40))
    wait_until(lambda: last_view_is(panel, replace(paused, volume=40, volume_popup=True)))

    clock.advance(1.9)
    time.sleep(0.2)
    assert last_view_is(panel, replace(paused, volume=40, volume_popup=True))
    clock.advance(0.1)
    wait_until(lambda: last_view_is(panel, replace(paused, volume=40)))


def test_same_volume_or_reconnect_does_not_show_popup(service, display):
    _, panel = display()
    wait_until(lambda: service.subscriptions)
    service.push(snapshot(state="paused"))
    service.push(snapshot(state="paused", title="Other"))
    other = View("paused", "Other", "Artist", position=10, duration=100, volume=35, queue_position=0)
    wait_until(lambda: last_view_is(panel, other))

    service.drop()
    wait_until(lambda: len(service.subscriptions) == 2, timeout=2.5)
    service.push(snapshot(state="paused", volume=50))  # primer snapshot de la conexión nueva

    wait_until(lambda: last_view_is(panel, replace(other, title="Song", volume=50)))
    assert not any(img == render(replace(other, title="Song", volume=50, volume_popup=True)).tobytes()
                   for img in panel.images)


# Desplazamiento del título (SPEC 18)

LONG = "A very long song title that never ends at all"


@pytest.mark.parametrize("elapsed, expected", [
    (0, 0), (SCROLL_PAUSE, 0), (SCROLL_PAUSE + 1, SCROLL_SPEED), (SCROLL_PAUSE + 100 / SCROLL_SPEED, 100),  # 100 = tope
    (SCROLL_PAUSE + 100 / SCROLL_SPEED + 0.9, 100),  # pausa al final
    (2 * SCROLL_PAUSE + 100 / SCROLL_SPEED + 0.1, 0),  # vuelve al inicio
])
def test_scroll_offset(elapsed, expected):
    assert scroll_offset(elapsed, 100) == expected


def test_long_title_scrolls_pauses_and_returns(service, display, clock):
    _, panel = display()
    wait_until(lambda: service.subscriptions)
    service.push(snapshot(title=LONG))
    start = replace(PLAYING, title=LONG)
    wait_until(lambda: last_view_is(panel, start))
    end = title_overflow(LONG)
    travel = end / SCROLL_SPEED

    clock.advance(SCROLL_PAUSE + 1)
    wait_until(lambda: last_view_is(panel, replace(start, position=12, scroll=SCROLL_SPEED)))
    clock.advance(travel)
    wait_until(lambda: panel.shows(replace(start, position=12 + int(travel), scroll=end)))
    clock.advance(SCROLL_PAUSE)
    wait_until(lambda: last_view_is(panel, replace(start, position=12 + int(travel + SCROLL_PAUSE), scroll=0)))


@pytest.mark.parametrize("state", ["paused", "stopped"])
def test_long_title_does_not_scroll_when_not_playing(service, display, clock, state):
    _, panel = display(idle_clock_seconds=None)
    wait_until(lambda: service.subscriptions)
    service.push(snapshot(state=state, title=LONG))
    wait_until(lambda: last_view_is(panel, View(state, LONG, "Artist", position=10, duration=100, volume=35,
                                                queue_position=0)))
    count = len(panel.images)

    clock.advance(3)
    time.sleep(0.2)
    assert len(panel.images) == count


def test_new_snapshot_with_same_title_keeps_scrolling(service, display, clock):
    _, panel = display()
    wait_until(lambda: service.subscriptions)
    service.push(snapshot(title=LONG))
    wait_until(lambda: last_view_is(panel, replace(PLAYING, title=LONG)))
    clock.advance(SCROLL_PAUSE + 1)

    service.push(snapshot(title=LONG, position=11, volume=35))  # p. ej. un seek: no reinicia el desplazamiento
    wait_until(lambda: last_view_is(panel, replace(PLAYING, title=LONG, position=11, scroll=SCROLL_SPEED)))


def test_scrolling_uses_fast_tick_and_short_title_does_not(service, display):
    _, panel = display(tick_seconds=1.0, real_clock=True)
    wait_until(lambda: service.subscriptions)
    service.push(snapshot(title="Song"))
    wait_until(lambda: panel.shows(PLAYING))
    count = len(panel.images)
    time.sleep(0.5)
    assert len(panel.images) <= count + 1  # a lo sumo el cambio de segundo

    service.push(snapshot(title=LONG))
    time.sleep(SCROLL_PAUSE + 1.0)
    assert len(panel.images) >= count + 3  # ~0,2 s por cuadro mientras se desplaza


# Ahorro de pantalla (SPEC 18). El reloj falso arranca el sábado 24 a las 21:47:30.

def at(hhmm):
    h, m = map(int, hhmm.split(":"))
    return clock_time(h, m)


@pytest.mark.parametrize("t, start, end, inside", [
    ("23:30", "23:00", "07:00", True), ("03:00", "23:00", "07:00", True), ("07:00", "23:00", "07:00", False),
    ("12:00", "23:00", "07:00", False), ("23:00", "23:00", "07:00", True),
    ("13:00", "12:00", "14:00", True), ("14:00", "12:00", "14:00", False), ("11:59", "12:00", "14:00", False),
])
def test_in_range(t, start, end, inside):
    assert in_range(at(t), at(start), at(end)) == inside


def test_night_turns_panel_off_inside_and_on_after(service, display, clock):
    d, panel = display(idle_clock_seconds=None, night=(at("21:48"), at("21:50")))  # cruza al minuto siguiente
    wait_until(lambda: service.subscriptions)
    service.push(snapshot(state="paused"))
    wait_until(lambda: len(panel.images) >= 2)
    assert panel.power == []

    clock.advance(30)  # 21:48:00
    wait_until(lambda: panel.power == ["off"])
    count = len(panel.images)
    service.push(snapshot(state="paused", title="Other"))
    time.sleep(0.2)
    assert len(panel.images) == count  # apagada: no se dibuja

    clock.advance(120)  # 21:50:00
    wait_until(lambda: panel.power == ["off", "on"])
    wait_until(lambda: panel.shows(View("paused", "Other", "Artist", position=10, duration=100, volume=35,
                                        queue_position=0)))


def test_night_range_across_midnight_starts_off(service, display, clock):
    _, panel = display(night=(at("21:00"), at("07:00")))

    wait_until(lambda: panel.power == ["off"])


def test_off_after_stopped_minutes(service, display, clock):
    _, panel = display(idle_clock_seconds=None, off_after_stopped_minutes=2)
    wait_until(lambda: service.subscriptions)
    service.push(snapshot(state="paused"))
    wait_until(lambda: len(panel.images) >= 2)
    clock.advance(300)  # pausa no cuenta
    time.sleep(0.2)
    assert panel.power == []

    service.push(snapshot(state="stopped"))
    wait_until(lambda: last_view_is(panel, View("stopped", "Song", "Artist", position=10, duration=100, volume=35,
                                                queue_position=0)))
    clock.advance(119)
    time.sleep(0.2)
    assert panel.power == []
    clock.advance(1)
    wait_until(lambda: panel.power == ["off"])

    service.push(snapshot())  # empezar a reproducir la enciende
    wait_until(lambda: panel.power == ["off", "on"])
    wait_until(lambda: panel.shows(PLAYING))


def test_button_wakes_for_ten_seconds(service, display, clock):
    d, panel = display(night=(at("21:00"), at("07:00")))
    wait_until(lambda: panel.power == ["off"])

    d.wake()
    wait_until(lambda: panel.power == ["off", "on"])
    clock.advance(WAKE_SECONDS - 0.5)
    time.sleep(0.2)
    assert panel.power == ["off", "on"]
    clock.advance(0.5)
    wait_until(lambda: panel.power == ["off", "on", "off"])


def test_playing_at_night_wakes_for_ten_seconds(service, display, clock):
    _, panel = display(night=(at("21:00"), at("07:00")))
    wait_until(lambda: service.subscriptions)
    service.push(snapshot(state="paused"))
    wait_until(lambda: panel.power == ["off"])

    service.push(snapshot())
    wait_until(lambda: panel.power == ["off", "on"])
    wait_until(lambda: panel.shows(PLAYING))
    clock.advance(WAKE_SECONDS)
    wait_until(lambda: panel.power == ["off", "on", "off"])


def test_without_power_fields_never_turns_off(service, display, clock):
    _, panel = display()
    wait_until(lambda: service.subscriptions)
    service.push(snapshot(state="stopped"))
    wait_until(lambda: len(panel.images) >= 2)

    clock.advance(86400)
    time.sleep(0.2)
    assert panel.power == []


# Modo carátula (SPEC 19)

def png(color):
    buffer = io.BytesIO()
    Image.new("RGB", (300, 300), color).save(buffer, "PNG")
    return buffer.getvalue()


def center_of_last(panel):
    image = Image.frombytes("RGB", (240, 240), panel.images[-1])
    return image.getpixel((120, 60))  # arriba del centro: carátula, o negro en el placeholder


RED, BLUE = (200, 0, 0), (0, 0, 200)


def test_art_mode_fetches_and_shows_cover(service, display):
    service.covers["A"] = png(RED)
    _, panel = display()
    wait_until(lambda: service.subscriptions)
    service.push(snapshot(mode="art", album="A"))

    wait_until(lambda: panel.images and center_of_last(panel) == RED)
    assert service.cover_requests == ["A"]


def test_placeholder_while_loading_then_cover(service, display):
    service.covers["A"] = png(RED)
    service.cover_gate.clear()
    _, panel = display()
    wait_until(lambda: service.subscriptions)
    service.push(snapshot(mode="art", album="A"))

    placeholder = View("playing", "Song", "Artist", album="A", position=10, duration=100, volume=35,
                       queue_position=0, mode="art")
    wait_until(lambda: last_view_is(panel, placeholder))
    service.cover_gate.set()
    wait_until(lambda: center_of_last(panel) == RED)


@pytest.mark.parametrize("cover", [None, b"not an image"])
def test_no_cover_or_undecodable_shows_placeholder(service, display, cover):
    if cover is not None:
        service.covers["A"] = cover
    _, panel = display()
    wait_until(lambda: service.subscriptions)
    service.push(snapshot(mode="art", album="A"))
    wait_until(lambda: service.cover_requests == ["A"])
    time.sleep(0.3)

    assert last_view_is(panel, View("playing", "Song", "Artist", album="A", position=10, duration=100, volume=35,
                                    queue_position=0, mode="art"))


def test_same_album_is_fetched_once_and_new_album_fetches_again(service, display):
    service.covers.update(A=png(RED), B=png(BLUE))
    _, panel = display()
    wait_until(lambda: service.subscriptions)
    service.push(snapshot(mode="art", album="A", title="One"))
    wait_until(lambda: center_of_last(panel) == RED)

    service.push(snapshot(mode="art", album="A", title="Two"))
    time.sleep(0.3)
    assert service.cover_requests == ["A"]

    service.push(snapshot(mode="art", album="B"))
    wait_until(lambda: center_of_last(panel) == BLUE)
    assert service.cover_requests == ["A", "B"]


def test_track_and_clock_modes_never_fetch(service, display):
    service.covers["A"] = png(RED)
    _, panel = display()
    wait_until(lambda: service.subscriptions)
    service.push(snapshot(mode="track", album="A"))
    service.push(snapshot(mode="clock", album="A"))
    wait_until(lambda: len(panel.images) >= 3)
    time.sleep(0.3)

    assert service.cover_requests == []


def test_reentering_art_reuses_cover_but_retries_missing_one(service, display):
    service.covers["A"] = png(RED)
    _, panel = display()
    wait_until(lambda: service.subscriptions)
    service.push(snapshot(mode="art", album="A"))
    wait_until(lambda: center_of_last(panel) == RED)
    service.push(snapshot(mode="track", album="A"))
    service.push(snapshot(mode="art", album="A"))
    wait_until(lambda: center_of_last(panel) == RED)
    time.sleep(0.2)
    assert service.cover_requests == ["A"]  # en caché

    service.push(snapshot(mode="art", album="B"))  # B sin carátula
    wait_until(lambda: service.cover_requests == ["A", "B"])
    service.push(snapshot(mode="track", album="B"))
    service.push(snapshot(mode="art", album="B"))
    wait_until(lambda: service.cover_requests == ["A", "B", "B"])  # al volver a entrar, reintenta


def test_cover_of_previous_album_arriving_late_is_discarded(service, display):
    service.covers.update(A=png(RED), B=png(BLUE))
    service.cover_gate.clear()
    _, panel = display()
    wait_until(lambda: service.subscriptions)
    service.push(snapshot(mode="art", album="A"))
    wait_until(lambda: service.cover_requests == ["A"])
    service.push(snapshot(mode="art", album="B"))
    wait_until(lambda: service.cover_requests == ["A", "B"])

    service.cover_gate.set()
    wait_until(lambda: center_of_last(panel) == BLUE)
    time.sleep(0.3)
    assert center_of_last(panel) == BLUE


def test_idle_clock_overrides_art_without_fetching_again(service, display, clock):
    service.covers["A"] = png(RED)
    _, panel = display(idle_clock_seconds=60)
    wait_until(lambda: service.subscriptions)
    service.push(snapshot(state="paused", mode="art", album="A"))
    wait_until(lambda: panel.images and center_of_last(panel) == RED)

    clock.advance(60)
    wait_until(lambda: last_view_is(panel, View("paused", "Song", "Artist", album="A", position=10, duration=100,
                                                volume=35, queue_position=0, mode="clock", clock="21:48",
                                                date="sáb 24 oct")))
    service.push(snapshot(mode="art", album="A"))  # play: vuelve a art con la carátula en caché
    wait_until(lambda: center_of_last(panel) == RED)
    assert service.cover_requests == ["A"]


# Avisos de gestos (SPEC 20)

PAUSED = View("paused", "Song", "Artist", position=10, duration=100, volume=35, queue_position=0)


def paused_display(service, display):
    d, panel = display()
    wait_until(lambda: service.subscriptions)
    service.push(snapshot(state="paused"))
    wait_until(lambda: last_view_is(panel, PAUSED))
    return d, panel


def test_toast_shows_at_once_and_goes_after_its_seconds(service, display, clock):
    d, panel = paused_display(service, display)

    d.toast("+10 s")
    assert last_view_is(panel, replace(PAUSED, toast="+10 s"))  # dibujado en la llamada, sin esperar al tick

    clock.advance(1.4)
    time.sleep(0.2)
    assert last_view_is(panel, replace(PAUSED, toast="+10 s"))
    clock.advance(0.1)
    wait_until(lambda: last_view_is(panel, PAUSED))


def test_new_toast_replaces_and_none_removes(service, display):
    d, panel = paused_display(service, display)

    d.toast("Apagar 3…")
    d.toast("Apagar 2…")
    assert last_view_is(panel, replace(PAUSED, toast="Apagar 2…"))
    d.toast(None)
    assert last_view_is(panel, PAUSED)


def test_shutting_down_stays(service, display, clock):
    d, panel = paused_display(service, display)

    d.shutting_down()
    clock.advance(10)  # mucho más que los 1,5 s de un aviso común
    service.push(snapshot(state="stopped"))
    wait_until(lambda: last_view_is(panel, replace(PAUSED, status="stopped", toast="Apagando…")))


def test_toast_over_offline(service, display):
    service.available = False
    d, panel = display()
    wait_until(lambda: last_view_is(panel, View("offline")))

    d.toast("Menú: próximamente")
    assert last_view_is(panel, View("offline", toast="Menú: próximamente"))


def test_toast_before_panel_init_does_not_draw(service, clock):
    panel = FakePanel()
    d = Display("/x.sock", panel, connect=service.connect, monotonic=clock.monotonic, now=clock.now)

    d.toast("+10 s")
    assert panel.images == []


# Menú (SPEC 21)

def open_menu(service, clock, **power):
    """Display con un Menu real (sin IPC: solo la raíz) cuyo changed es refresh()."""
    from menu import Menu
    holder = {}
    menu = Menu(lambda message: None, power_off=lambda: None, toast=lambda text: None,
                changed=lambda: holder["d"].refresh() if "d" in holder else None,
                run=lambda job: job(), monotonic=clock.monotonic)
    panel = FakePanel()
    d = Display("/x.sock", panel, connect=service.connect, tick_seconds=0.05, retry_seconds=0.1,
                monotonic=clock.monotonic, now=clock.now, menu=menu, **power)
    holder["d"] = d
    d.start()
    return d, panel, menu


ROOT = MenuView("Menú", ("Biblioteca", "Listas", "Cola", "Apagar"), 0)


@pytest.fixture
def stop_after():
    created = []
    yield created.append
    for d in created:
        d.stop()


def test_menu_is_drawn_at_once_on_change_and_closes(service, clock, stop_after):
    d, panel, menu = open_menu(service, clock)
    stop_after(d)
    wait_until(lambda: service.subscriptions)
    service.push(snapshot(state="paused"))
    wait_until(lambda: last_view_is(panel, PAUSED))

    menu.open()
    assert last_view_is(panel, replace(PAUSED, menu=ROOT))  # dibujado en la llamada, sin esperar al tick
    menu.down()
    assert last_view_is(panel, replace(PAUSED, menu=replace(ROOT, cursor=1)))
    menu.close()
    assert last_view_is(panel, PAUSED)


def test_menu_closes_after_timeout_on_tick(service, clock, stop_after):
    d, panel, menu = open_menu(service, clock)
    stop_after(d)
    wait_until(lambda: service.subscriptions)
    service.push(snapshot(state="paused"))
    wait_until(lambda: last_view_is(panel, PAUSED))
    menu.open()

    clock.advance(29.9)
    time.sleep(0.2)
    assert last_view_is(panel, replace(PAUSED, menu=ROOT))
    clock.advance(0.1)
    wait_until(lambda: last_view_is(panel, PAUSED))
    assert not menu.is_open


def test_menu_keeps_panel_on_at_night_until_closed(service, clock, stop_after):
    d, panel, menu = open_menu(service, clock, night=(at("21:00"), at("07:00")))
    stop_after(d)
    wait_until(lambda: panel.power == ["off"])

    menu.open()  # abrirlo es un botón: en el agente, wake() también
    wait_until(lambda: panel.power == ["off", "on"])
    clock.advance(WAKE_SECONDS + 5)  # más que el encendido de un botón, menos que el timeout
    time.sleep(0.2)
    assert panel.power == ["off", "on"]
    menu.close()
    wait_until(lambda: panel.power == ["off", "on", "off"])


def test_queue_position_comes_from_last_snapshot(service, display):
    d, panel = display()
    assert d.queue_position() is None
    wait_until(lambda: service.subscriptions)
    service.push({**snapshot(), "queuePosition": 4})

    wait_until(lambda: d.queue_position() == 4)


def test_refresh_before_panel_init_does_not_draw(service, clock):
    panel = FakePanel()
    d = Display("/x.sock", panel, connect=service.connect, monotonic=clock.monotonic, now=clock.now)

    d.refresh()
    assert panel.images == []
