FireMask/OpenPlayer/(commit log)

2026-10-20 feat: Add initial architecture, assembly, battery design, GPIO mapping, and .NET solution specs for OpenPlayer
    - Introduced architecture documentation outlining the purpose, hardware, architectural principles, logical diagram, components, IPC, button mapping, and development phases.
    - Created assembly guide detailing the setup process for Raspberry Pi Zero 2 W, including OS installation, DAC validation, MPD configuration, and initial SSH controls.
    - Developed battery design document specifying requirements for portable power, including electrical specifications, consumption measurement, and safe shutdown strategies.
    - Established GPIO mapping for button controls, including electrical rules,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
2026-10-20 feat: Add ButtonName enum and ButtonNames class with parsing logic and tests
2026-10-20 feat: Implement ButtonCommandHandler and corresponding tests for button command handling
2026-10-20 feat: Implement Previous button handling logic and corresponding tests for track navigation
2026-10-20 feat: Add volume control handling and corresponding tests for ButtonCommandHandler
2026-10-20 feat: Add SeekAsync method to IPlayer interface and update button mapping logic for previous track handling
2026-10-20 feat: Add deploy.ps1 script for compiling and installing OpenPlayer.Service on Raspberry Pi
2026-10-20 feat: Implement IPC message handling with JSON Lines for button commands and snapshot requests
2026-10-20 docs: Update README and architecture documentation for IPC socket implementation and message handling
2026-10-20 docs: Update status in IPC Unix socket specification from Approved to Implemented
2026-10-20 feat: Implement hardware agent configuration and tests for GPIO buttons
2026-10-20 feat: Add Sender class for IPC communication and implement tests for button events
2026-10-20 feat: Implement GPIO button handling and tests for button press events
2026-10-20 feat: Implement main functionality for GPIO button handling and IPC communication
2026-10-20 feat: Update documentation for hardware agent and GPIO button handling
2026-10-21 feat: Enhance MPD audio output documentation with ALSA device configuration details
2026-10-21 feat: Add Samba music import documentation to assembly guide and README
2026-10-21 feat: Update Samba configuration details in assembly documentation and mark SPEC 07 as implemented
2026-10-21 feat: Add IPC client and tests for button press and snapshot functionality
2026-10-21 feat: Add web agent server and HTML interface with button functionality
2026-10-21 feat: Enhance button logging in IpcServer and add web agent main script with configuration tests
2026-10-21 feat: Add 'Refresh Library' button and functionality to update music library
2026-10-21 feat: Enhance queue management with auto-scroll and current item highlighting
2026-10-22 feat: Implement queue editing functionality in web agent with MPD track ID support
2026-10-22 feat: Add support for track ID in MpdEntryParser and update tests for ID validation
2026-10-22 feat: Enhance queue interface with clear button and editing actions
2026-10-24 feat: Add GC9A01 display driver and corresponding tests
2026-10-24 fix: Update GC9A01 display rotation to 180 degrees and adjust related documentation
    [gc9a01.py, test_config.py]
2026-10-24 feat: Add optional display configuration fields for idle clock, night mode, and power-off settings
2026-10-24 feat: Add power management for display; implement sleep and wake functionality based on inactivity and night mode
2026-10-24 feat: Add screen modes for round display; toggle between track and clock, enhance documentation
2026-10-25 fix: Move display DC/RST to GPIO16/26, scroll at 5 fps and mark SPEC 18 Implemented
    - DC/RST moved from GPIO5/6 (pins 29/31) to GPIO16/26 (pins 36/37), GND to pin 34,
    after a short between pins 29-31 left the panel in reset.
    - Title scrolling at 5 fps: measured 28% of a core at 10 fps vs 14% at 5 fps on the Pi Zero 2 W.
    - Fix race in test_off_after_stopped_minutes.
    - Tick SPEC 18 acceptance criteria and set status to Implemented.
    Claude-Session: https://claude.ai/code/session_0198WPax9Yp1LRqUB5vHM4fv
    [display.py, test_config.py, test_display.py]
2026-10-25 feat: Implement player.get_cover for current track cover retrieval; add CoverMessage and related tests
2026-10-25 docs: Document album art mode and mark SPEC 19 Implemented
    - README, architecture.md and assembly.md describe the art mode and player.get_cover.
    - Roadmap: album art done.
    - Tick SPEC 19 acceptance criteria with Pi measurements (cover 0.07 s + 0.26 s decode, 8 % CPU).
    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
2026-10-25 fix: Hide album art between the volume and progress rings during the volume popup
    The popup's black disc stopped at radius 106, leaving the cover visible up to the
    progress ring's inner edge (111). The disc now reaches that edge (+1 px for antialiasing).
    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
    [screen.py, test_screen.py]
2026-10-25 feat: Implement power off functionality and button gesture handling in SPEC 20
2026-10-25 feat: Add polkit rule for power off functionality and update deployment scripts
2026-10-25 feat: Implement button gesture handling and power off functionality for SPEC 20
2026-10-25 feat: Implement button gesture handling and toast notifications for SPEC 20
2026-10-25 feat: Enhance button gesture handling with power off functionality for SPEC 20
2026-10-25 docs: Record calibrated holdSeconds and verified polkit rule for SPEC 20
    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
2026-10-26 feat: Add project requirements documentation for OpenPlayer PCB Rev A
2026-10-26 Update GPIO mapping and PCB requirements for OpenPlayer project
    - Added detailed GPIO mapping for buttons and display connections in gpio-map.md.
    - Revised PCB requirements to reflect the new charging module and button board connector specifications.
    - Introduced a new SPEC 22 document outlining the carrier PCB design, including net connections and footprint details.
    - Clarified the power management and battery connections, ensuring no direct battery current flows through the PCB.
    - Updated implementation plan and acceptance criteria for the PCB design process.
2026-10-26 feat: Add netlist script for OpenPlayer carrier PCB (SPEC 22)
2026-10-26 Add script to generate KiCad schematic from netlist
    This commit introduces a new Python script, build_sch.py, which generates the KiCad schematic file (openplayer-carrier.kicad_sch) and project file (.kicad_pro) based on the netlist data. The script utilizes KiCad's symbol libraries and positions components according to predefined coordinates. It ensures that every pin is labeled correctly and handles unused pins with a no-connect flag. The generated files are structured to be compatible with KiCad version 10.0.
    [openplayer-carrier.kicad_sch]
2026-10-26 Refactor PCB schematic and build scripts
    - Updated the BOM inclusion for test points in the schematic to exclude them from the BOM.
    - Modified the build_sch.py script to conditionally set the BOM inclusion based on the reference type.
    - Introduced a new build_pcb.py script to automate the generation of the PCB layout from the netlist, including outline, placement, silkscreen, and net definitions.
    - Adjusted the placement of components on the PCB to improve layout and accessibility.
    - Enhanced text labeling for connectors and pins on the PCB for better clarity and readability.
    [openplayer-carrier.kicad_pcb, openplayer-carrier.kicad_sch]
2026-10-26 Add routing functionality to PCB build script
    - Implemented a grid-based router using Dijkstra's algorithm for routing tracks on F.Cu and B.Cu layers.
    - Introduced new constants for track widths, clearance, and via dimensions.
    - Added a Router class to manage routing logic, including pathfinding and obstacle handling.
    - Enhanced the build process to include routing of specified nets in a defined order.
    - Integrated ground stitching vias to ensure connectivity between ground pours on both layers.
    [openplayer-carrier.kicad_pcb]
2026-10-26 Add fabrication files for openplayer-carrier PCB
    - Created Gerber job file for openplayer-carrier PCB.
    - Added drill file for openplayer-carrier PCB.
    - Generated BOM CSV for openplayer-carrier components.
    - Included zipped Gerber files for fabrication.
    - Added top and bottom render images of the PCB.
    - Implemented PowerShell script for automated fabrication output generation.
    [openplayer-carrier-bom.csv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]
2026-10-26 feat: Add README for OpenPlayer carrier PCB with setup instructions and connector details
2026-10-26 docs: Mark SPEC 22 as Implemented and tick acceptance criteria
    Regenerate the carrier PCB and fabrication outputs from the final scripts,
    keep KiCad's project defaults, and ignore KiCad lock files.
    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
    [openplayer-carrier-B_Cu.gbl, openplayer-carrier-B_Mask.gbs, openplayer-carrier-B_Silkscreen.gbo, openplayer-carrier-Edge_Cuts.gm1, openplayer-carrier-F_Cu.gtl, openplayer-carrier-F_Mask.gts, openplayer-carrier-F_Silkscreen.gto, openplayer-carrier-job.gbrjob]
2026-10-26 Refactor PCB and schematic generation scripts; introduce shared module
    - Moved common functionality to `hardware/common/pcbgen.py` for reuse across PCB and schematic generation.
    - Updated `build_pcb.py` and `build_sch.py` to utilize the new shared module, simplifying code and improving maintainability.
    - Added new button board specification, detailing design requirements and implementation plan for a button strip PCB.
    - Ensured compatibility with existing carrier PCB and netlist structure, maintaining design integrity.
2026-10-26 feat: Add netlist module for SPEC 23 button board with parts and nets definition
2026-10-26 feat: Add initial schematic and project files for OpenPlayer buttons
    [openplayer-buttons.kicad_sch]
2026-10-26 Add PCB generation script for button board and update specifications
    - Introduced `build_pcb.py` script to generate the KiCad PCB layout for the button board.
    - The script calculates the layout based on defined parameters such as button pitch, group gaps, and board dimensions.
    - Updated `23-button-board-pcb.md` to reflect changes in the end margin for the PCB design.
    [openplayer-buttons.kicad_pcb]
2026-10-26 Add routing functionality to build_pcb.py
    - Updated the script to include routing for signal tracks.
    - Introduced a new constant for signal track width and defined a route order for button nets.
    - Implemented a router to handle net routing and GND pour stitching.
    [openplayer-buttons.kicad_pcb]
2026-10-26 Refactor code structure for improved readability and maintainability
    [openplayer-buttons-bom.csv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]
2026-10-26 docs: Mark SPEC 23 as Implemented and tick acceptance criteria
    Also commit the button board's .kicad_pro as filled in by build_pcb.py
    (design settings), matching how the carrier's project file is tracked.
    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
2026-10-27 docs: Add SPEC 24 documentation for Carrier PCB Rev B
2026-10-27 Update footprint properties for connectors and capacitors in Carrier PCB schematic
    [openplayer-carrier.kicad_sch]
2026-10-27 Refactor PCB layout for Rev B: adjust dimensions, reposition components, and implement C1 body outline with keep-out area
    [openplayer-carrier.kicad_pcb]
2026-10-27 Implement code changes to enhance functionality and improve performance
    [openplayer-carrier.kicad_pcb]
2026-10-27 Refactor silkscreen function in build_pcb.py for improved readability and maintainability
    - Introduced a new helper function `pads` to streamline the retrieval of connector pad positions.
    - Updated the silkscreen labeling logic for connectors J4 and J5 to enhance clarity and organization.
    - Adjusted text positioning for better alignment and visibility on the PCB.
    - Changed references from "Rev A" to "Rev B" in the text labels to reflect the latest version.
    [openplayer-carrier.kicad_pcb]
2026-10-27 Update PCB fabrication files for OpenPlayer Carrier
    - Modified creation date in gerber job file to reflect latest changes.
    - Adjusted board dimensions in gerber job file.
    - Updated drill file with new creation date and modified drill coordinates.
    - Changed capacitor value and footprint in BOM for improved performance.
    - Updated connector types in BOM to horizontal orientation for better layout.
    - Recompiled gerbers and updated zip file for fabrication.
    - Updated render images for top and bottom views of the PCB.
    [openplayer-carrier-bom.csv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]
2026-10-27 Update documentation for OpenPlayer PCB Rev B: revise project requirements and connector details
2026-10-27 Mark SPEC 24 (carrier PCB Rev B) as implemented
    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
2026-10-27 Add images and specifications for Carrier PCB Rev C
2026-10-27 Update netlist.py for Carrier PCB Rev C: refine parts list and net connections
2026-10-27 Update button and carrier schematics: modify switch positions and add new connector J7
    [openplayer-buttons.kicad_sch, openplayer-carrier.kicad_sch]
2026-10-27 Update PCB design for Rev C: integrate Pi Zero, adjust dimensions, and enhance layout
    - Changed board dimensions to accommodate Pi Zero and GC9A01 module.
    - Updated component placements and added new connectors for improved accessibility.
    - Implemented new functions for Pi overlay and display outline.
    - Added DRC rules for display standoffs and antenna keepout area.
    - Enhanced documentation and comments for clarity on design changes.
    [openplayer-carrier.kicad_pcb]
2026-10-27 Fix PCB layout and silkscreen labels for OpenPlayer carrier Rev C
    - Adjusted placement of component C2 for better alignment.
    - Updated NAMES dictionary to include J7 (PWR_BTN).
    - Modified silkscreen text positioning for J4 and J5 to enhance visibility.
    - Changed version label from Rev B to Rev C and updated related text.
    - Added warning text regarding the use of the Pi micro-USB power.
    [openplayer-carrier.kicad_pcb]
2026-10-27 Refactor button layout and update PCB design for OpenPlayer Rev B
    - Adjusted button pitch to 9.6 mm for improved spacing.
    - Modified button group configuration to exclude SW1 and clarify power connection.
    - Updated pin labels to reflect unused pin 8 as "NC" for clarity.
    - Changed silkscreen text to indicate revision B.
    - Enhanced net handling to include unconnected pins for better design integrity.
    [openplayer-buttons.kicad_pcb]
2026-10-27 Update OpenPlayer Carrier PCB files with new dimensions, drill specifications, and BOM changes
    - Modified creation date in gerber job file to reflect the latest update.
    - Adjusted board dimensions in the gerber job file for improved fit.
    - Updated drill file with new coordinates and hole sizes for better component placement.
    - Changed connector types in BOM for J1 and J5 to match the new design requirements.
    - Added new power button connector J7 to the BOM.
    - Updated gerbers and render images to reflect the latest design changes.
    [openplayer-buttons-bom.csv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]
2026-10-27 Update PCB documentation for Rev C: revise battery specifications, connector details, and layout descriptions
2026-10-27 Hide display module header models in PCB build script to prevent unnecessary visibility in the design.
    [openplayer-carrier-B_Cu.gbl, openplayer-carrier-B_Mask.gbs, openplayer-carrier-B_Silkscreen.gbo, openplayer-carrier-Edge_Cuts.gm1, openplayer-carrier-F_Cu.gtl, openplayer-carrier-F_Mask.gts, openplayer-carrier-F_Silkscreen.gto, openplayer-carrier-job.gbrjob]
2026-10-27 Update PCB documentation for Rev C: change status to Implemented, revise dimensions, and clarify design details
2026-10-27 Rev C follow-ups: fix stale requirement lines, drop J5 from the BOM
    - docs/pcb-requirements.md §3, §9, §11 no longer mention the ribbon or display cable
    - J5 (holes for the display module's own header) excluded from the BOM on
    both the symbol and the footprint, so parity still holds
    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
    [openplayer-carrier-bom.csv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]
